Omarwaleedsalah/Zigbee-CSS-PHY-Transmitter/Codes/Rtl/symbol_mapper.v

module symbol_mapper (clk,reset,valid_in,data_in,data_out, valid_out);
input  clk;
input  reset;
input  valid_in;
input  wire [5:0]  data_in;   // 6-bit input 
output reg  [31:0] data_out;  // 32-bit output 
output reg  valid_out;

    // ROM 
reg [31:0] mapper_rom [0:63];

initial begin
        mapper_rom[0]  = 32'b11111111111111111111111111111111;
        mapper_rom[1]  = 32'b10101010101010101010101010101010;
        mapper_rom[2]  = 32'b11001100110011001100110011001100;
        mapper_rom[3]  = 32'b10011001100110011001100110011001;
        mapper_rom[4]  = 32'b11110000111100001111000011110000;
        mapper_rom[5]  = 32'b10100101101001011010010110100101;
        mapper_rom[6]  = 32'b11000011110000111100001111000011;
        mapper_rom[7]  = 32'b10010110100101101001011010010110;
        mapper_rom[8]  = 32'b11111111000000001111111100000000;
        mapper_rom[9]  = 32'b10101010010101011010101001010101;
        mapper_rom[10] = 32'b11001100001100111100110000110011;
        mapper_rom[11] = 32'b10011001011001101001100101100110;
        mapper_rom[12] = 32'b11110000000011111111000000001111;
        mapper_rom[13] = 32'b10100101010110101010010101011010;
        mapper_rom[14] = 32'b11000011001111001100001100111100;
        mapper_rom[15] = 32'b10010110011010011001011001101001;
        mapper_rom[16] = 32'b11111111111111110000000000000000;//ffff0000
        mapper_rom[17] = 32'b10101010101010100101010101010101;
        mapper_rom[18] = 32'b11001100110011000011001100110011;
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
    end

always @(posedge clk) begin
        if (reset) begin
            data_out  <= 32'b0;
            valid_out <= 1'b0;
        end else begin
            valid_out <= valid_in;
            data_out <= mapper_rom[data_in];
           
        end
    end

endmodule
